UniversityOfIdahoCDACS/Power_Box/README.md

# Power_Box
Author: Nikolai Tiong

Contains a Fusion 360 Model of the Power Box and Lid that's attached to the FANUC Arm and documentation of the layout and hardware purchased.
