UniversityOfIdahoCDACS/Power_Box/FANUC Robot Arm Power Box ReadMe.docx

# FANUC Robot Arm Power Box

# Version 1.0

# Date: 12/17/20

# Author: Nikolai Tiong

# Overview

The Power Box is a customized attachment for the FANUC robot arm in the Venture Lab. It provides Power over Ethernet (PoE) through the conduit that goes up the arm to any device attached to the end of the arm.

Features:

- 25 Watts total power available
- 12V, 5V and 3.3V rails with screw terminals for connecting 20-24 AWG wires
- 5V USB and 3.3V USB
- Voltage and current displayed on the 5V and 3.3V buck converter modules
- A PoE port and a non PoE network port
- Fits above the conduit that leads to the end of the arm and screws into existing holes on the arm
- Case is 3D printed using the QIDI X-MAX printer in the Innovation Den lab

The 3D model is called PowerBoxV15.f3d

Power is provided by connecting an Ethernet cable to a PoE enabled switch and the other end is connected to the port indicated by the yellow cable on the figure below. Currently, doing this will cause the 2 buck converters to immediately turn on. A hardware will be added to prevent this from happening and give control over when power is enabled.

To Do:

- Add a power switch
- The buck converters requires a button sequence to turn USB power on, find a way to bypass the controller and make it always on

# Hardware

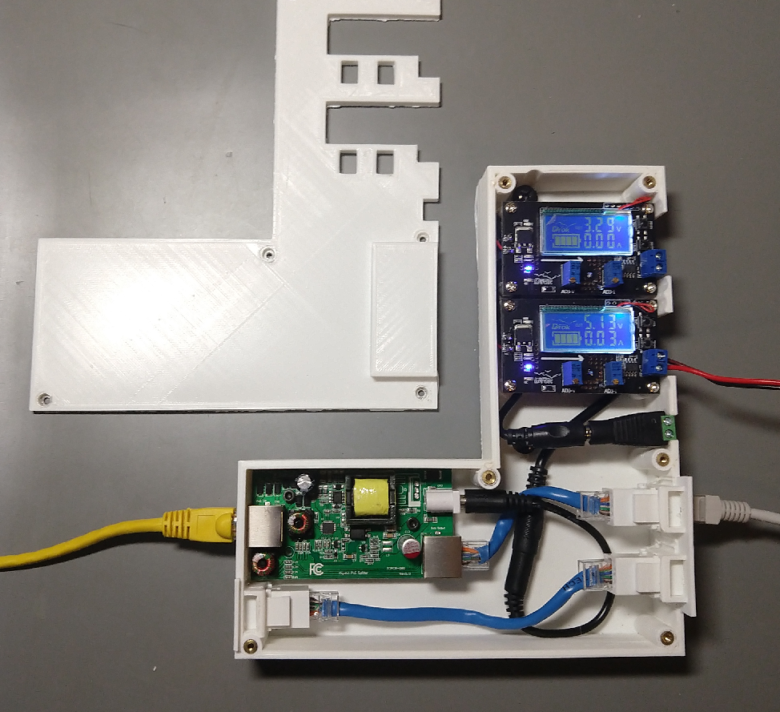
[picture p1: figure]

Figure 1: An open case look of the Power Box

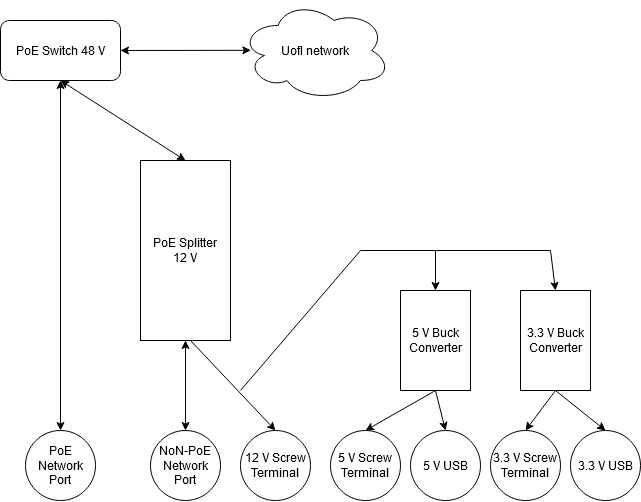
[picture p2: figure]

Figure 2: Diagram of the layout of the Power Box Hardware

# Hardware Purchased:

1x 25 W PoE Splitter $29

This takes a PoE enabled port and splits it up into a 12V DC barrel jack and non PoE networking.

https://www.amazon.com/GAT-12V25W-Volt-Splitter-Divided-Ethernet/dp/B07D7HYWQF

2x Buck converter $14

These takes the 12V DC power from the splitter and converts it to 5V and 3.3V DC power. The modules can be voltage and current adjusted via the potentiometers, but will be covered with a silicone sealant to prevent accidental modifications.

https://www.amazon.com/M%C3%B3dulo-convertidor-ajustable-reductor-voltaje/dp/B07JZ2GQJF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

1x Cat 6 F-F Keystone jack 10 pack $11

Used inside the power box

https://www.amazon.com/VICTEK-Female-Keystone-Couplers-White/dp/B01JJ46JX4

1x Screw Terminal block 50 pack $8

The buck converters had the output screw terminals on the wrong side – it prevented using the screws to tighten wires when facing upright. De-soldering the terminal blocks left them unusable and were replaced with these.

https://www.amazon.com/DGZZI-50pcs-Terminal-Connector-Arduino/dp/B07SZFGH4B/ref=psdc_306731011_t1_B07CK3RCKS

1x 15 12W POE Voltage Splitter $17

This was the first PoE splitter bought. It didn’t provide enough power to boot up a Raspberry Pi 4.

https://www.amazon.com/WT-GAF-12v12w-802-3af-Splitter-Ethernet-Switches/dp/B017J8WJ5E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

2x 3:1 DC Wire Splitter $7

Takes the 12V DC from the splitter and provides 3 lines.

https://www.amazon.com/Litever-Power-Splitter-Female-Plugs/dp/B075B222S4

1x 20 pack DC Barrel to screw terminal $5

https://www.amazon.com/Female-Power-Adapter-Connector-Camera/dp/B01ER6QWAY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

1x 5 pack DC male to male cable $12

https://www.amazon.com/Power-Adapter-Patch-Cable-2-1mm/dp/B07PFZ1XCC/ref=psdc_172544_t1_B00I6O1QAA

1x 50 ft 20 AWG Stranded Copper wire $9

https://www.amazon.com/American-Stranded-Conductor-Power-Speaker/dp/B0791B4ZRW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
