UniversityOfIdahoCDACS/Power_Box/(list of files, cad)

Other CAD files:
PowerBox V-Spring-2021.f3d
